CGCSAMR/Fotometro-Uchile/3D Printer/Piezas del Fotometro/Ensamblaje1.SLDASM

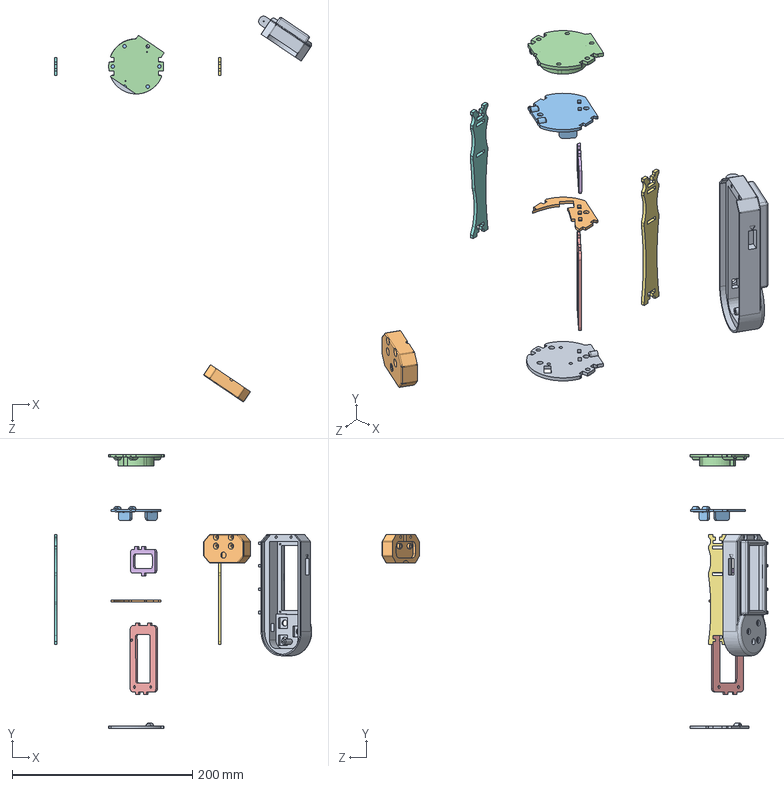
[picture p1: CAD file, 2014-07-22]
3D Printer/Piezas del Fotometro/Ensamblaje1.SLDASM
285.6 x 303.9 x 427.8 mm
segundo piso MAKERBOT
tercer piso MAKERBOT
cuarto piso PRINT edition MAKERBOT
quinto piso PRINT
central segundo pisoMAKERBOT
central tercer pisoMAKERBOT
soporte lateral MAKERBOT
soporte lateral MAKERBOT 2
soporte prueba
adaptador tipo A prueba
