CGCSAMR/Fotometro-Uchile/3D Printer/Piezas del Fotometro/Ensamblaje12.SLDASM

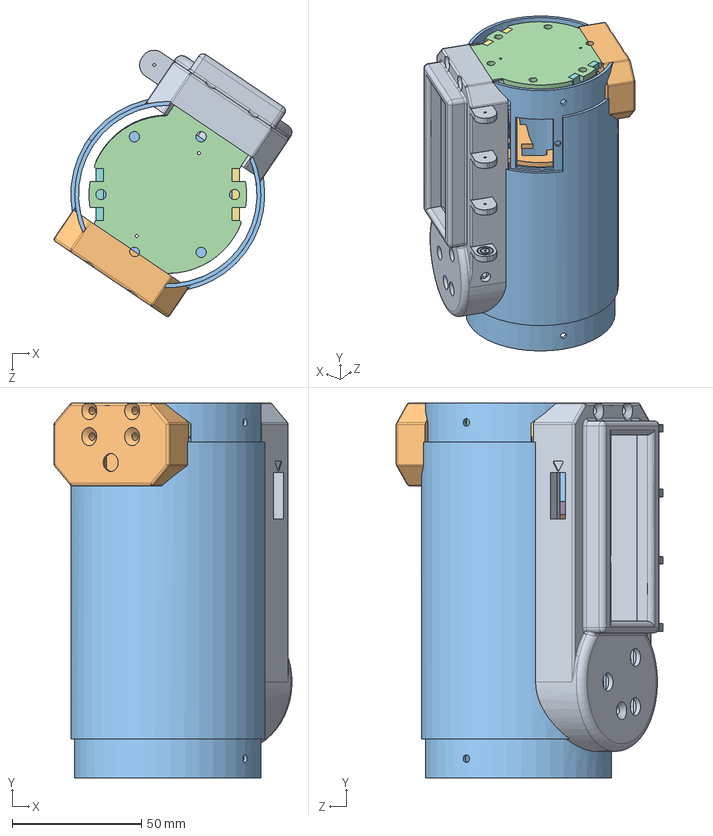
[picture p2: CAD file, 2014-07-22]
3D Printer/Piezas del Fotometro/Ensamblaje12.SLDASM
91.9 x 145.0 x 103.1 mm
segundo piso MAKERBOT
tercer piso MAKERBOT
cuarto piso PRINT edition MAKERBOT
quinto piso PRINT
central segundo pisoMAKERBOT
central tercer pisoMAKERBOT
soporte lateral MAKERBOT
soporte lateral MAKERBOT 2
soporte prueba
adaptador tipo A prueba
digitubo
