CGCSAMR/Fotometro-Uchile/CAD 3D/piezas del fotometro/fotometro.SLDASM

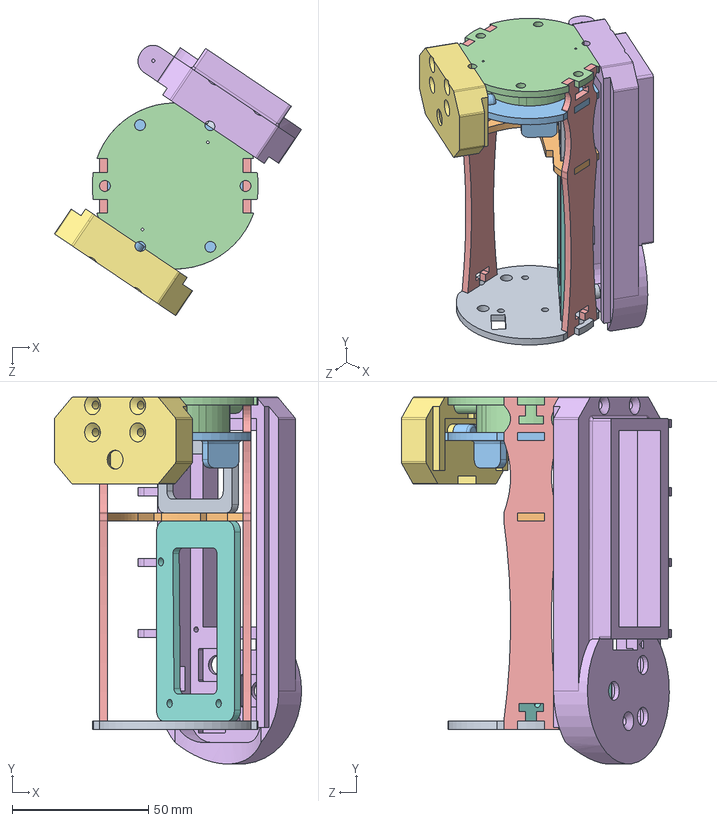
[picture p3: CAD file, 2014-02-21]
CAD 3D/piezas del fotometro/fotometro.SLDASM
90.7 x 134.7 x 99.3 mm
segundo piso
tercer piso
cuarto piso PRINT edition
quinto piso PRINT
soporte lateral x 2
soporte
adaptador tipo A
central segundo piso
central tercer piso
