CGCSAMR/Fotometro-Uchile/3D Printer/Piezas del Fotometro/Purgatorio/adaptador tipo A prueba 2013.STL

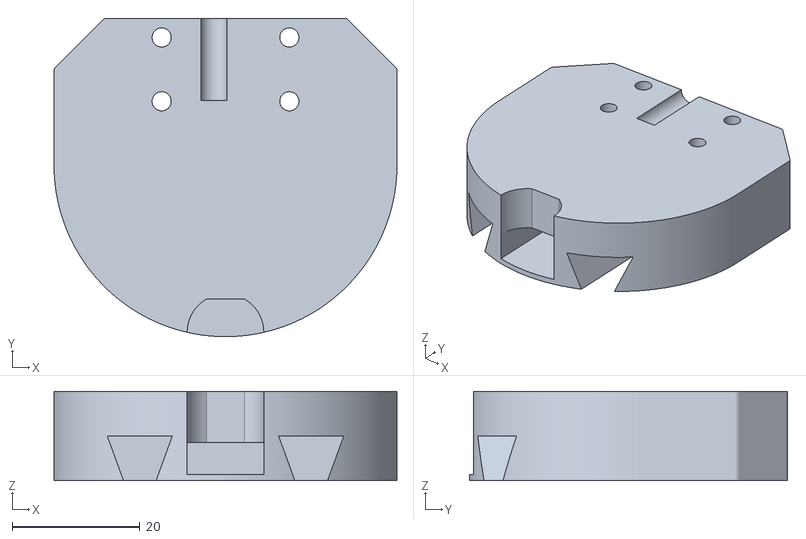
[picture p4: CAD file, 2014-07-22]
3D Printer/Piezas del Fotometro/Purgatorio/adaptador tipo A prueba 2013.STL
53.7 x 49.9 x 14.0
