CGCSAMR/Fotometro-Uchile/3D Printer/Piezas del Fotometro/soporte prueba mejorado.SLDPRT

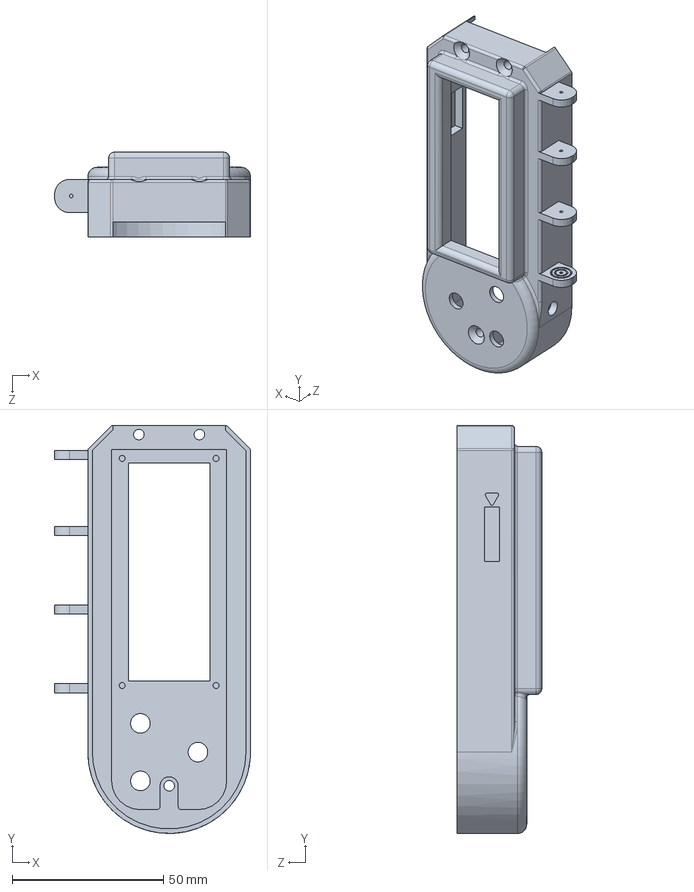
[picture p5: CAD file, 2014-08-05]
3D Printer/Piezas del Fotometro/soporte prueba mejorado.SLDPRT
64.7 x 134.7 x 28.0 mm
