CGCSAMR/Fotometro-Uchile/3D Printer/Piezas del Fotometro/STL/adaptador 2G.STL

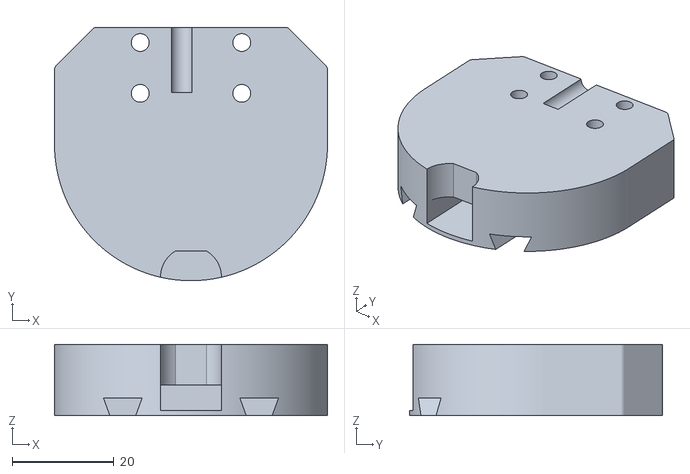
[picture p6: CAD file, 2014-07-25]
3D Printer/Piezas del Fotometro/STL/adaptador 2G.STL
53.7 x 49.9 x 14.0
