CGCSAMR/Fotometro-Uchile/CAD 3D/piezas del fotometro/central segundo pisoMAKERBOT.SLDPRT

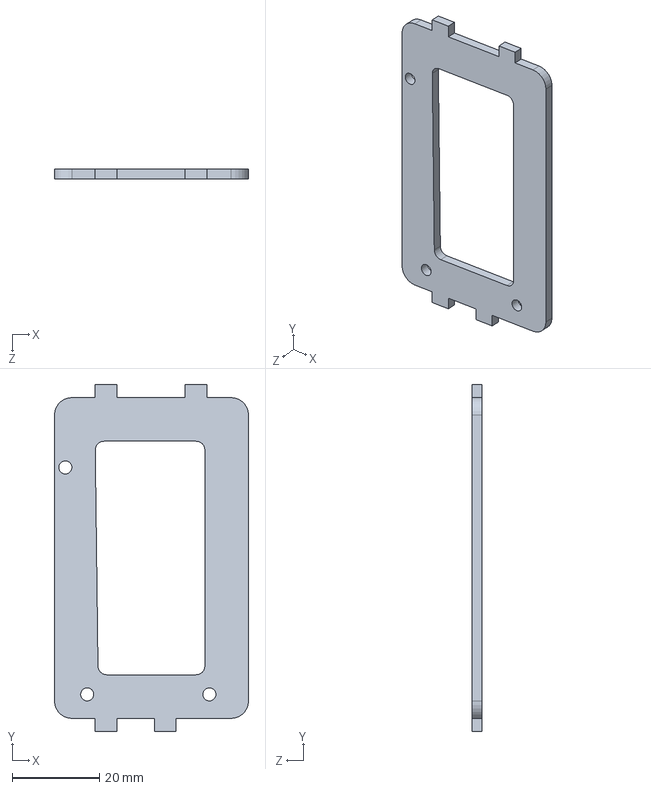
[picture p7: CAD file, 2014-02-21]
CAD 3D/piezas del fotometro/central segundo pisoMAKERBOT.SLDPRT
44.5 x 79.5 x 2.40 mm
