CGCSAMR/Fotometro-Uchile/3D Printer/Piezas del Fotometro/adaptador tipo A 2G.SLDPRT

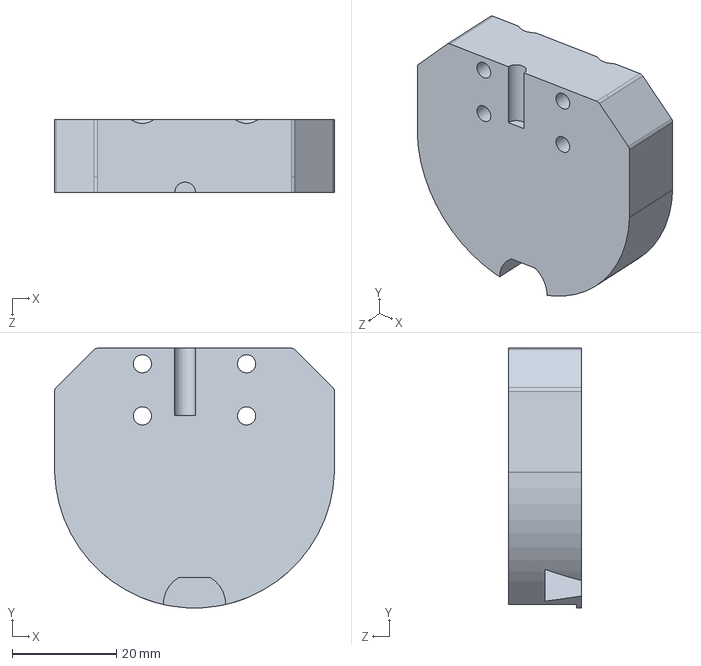
[picture p8: CAD file, 2014-08-02]
3D Printer/Piezas del Fotometro/adaptador tipo A 2G.SLDPRT
53.7 x 49.8 x 14.0 mm
