CGCSAMR/Fotometro-Uchile/3D Printer/Piezas del Fotometro/Purgatorio/adaptador tipo A prueba.STL

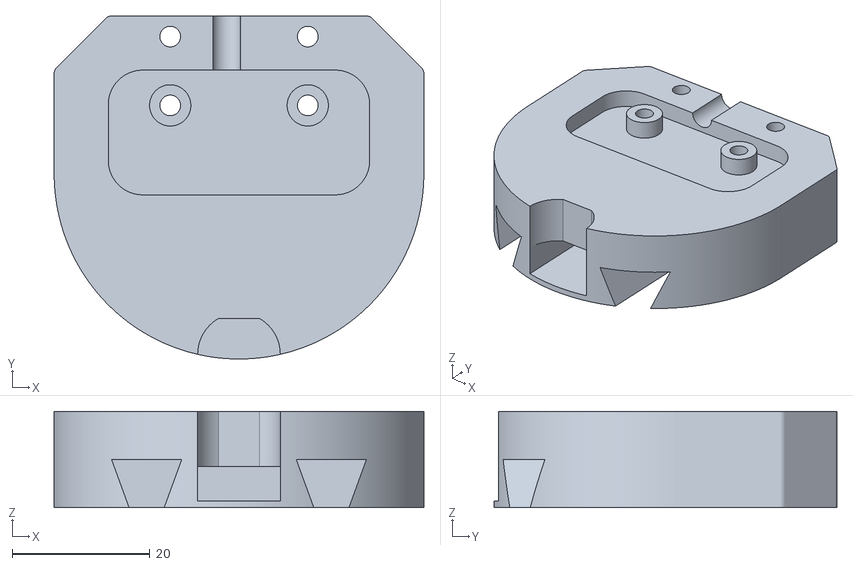
[picture p9: CAD file, 2014-07-22]
3D Printer/Piezas del Fotometro/Purgatorio/adaptador tipo A prueba.STL
53.7 x 49.9 x 14.0
