CGCSAMR/Fotometro-Uchile/3D Printer/Piezas del Fotometro/STL/quinto 1 piso PRINT.STL

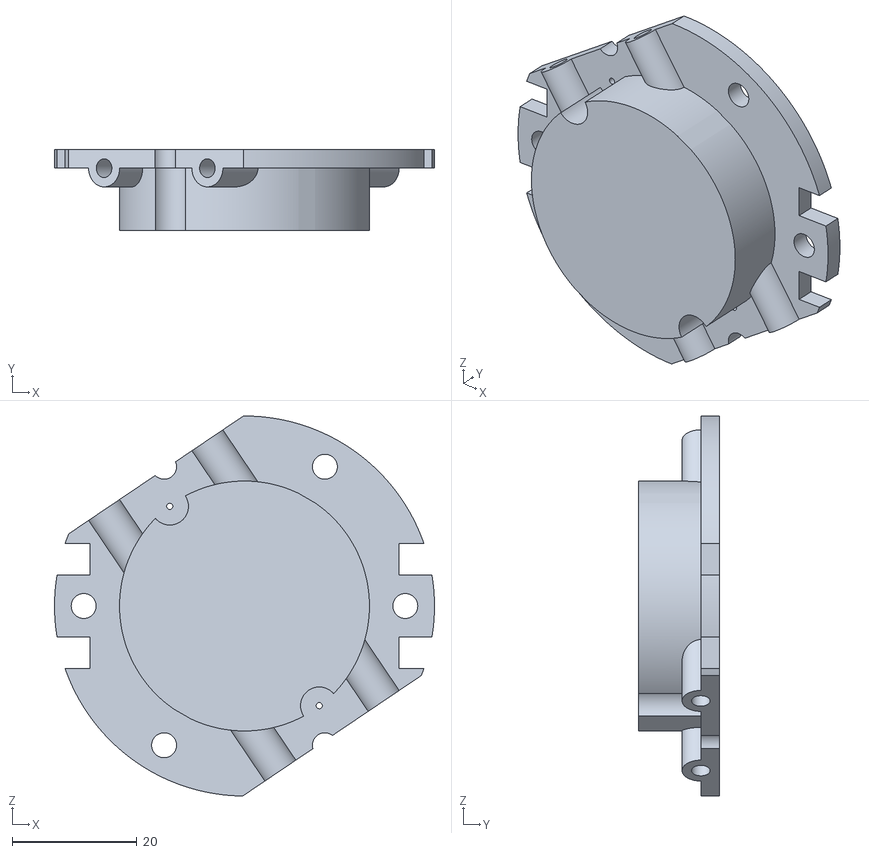
[picture p10: CAD file, 2014-02-21]
3D Printer/Piezas del Fotometro/STL/quinto 1 piso PRINT.STL
61.0 x 13.0 x 61.0
