CGCSAMR/Fotometro-Uchile/CAD 3D/piezas del fotometro/adaptador tipo A prueba.SLDPRT

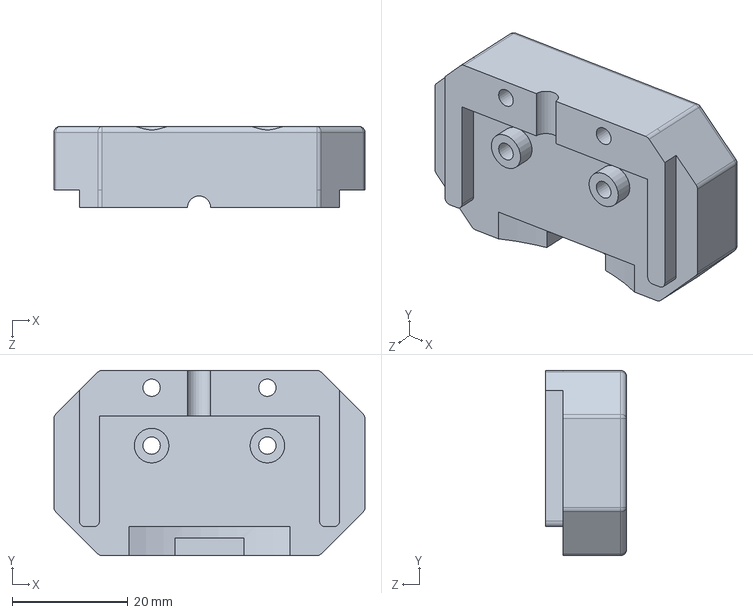
[picture p11: CAD file, 2014-02-21]
CAD 3D/piezas del fotometro/adaptador tipo A prueba.SLDPRT
53.7 x 32.0 x 14.0 mm
