CGCSAMR/Fotometro-Uchile/3D Printer/Piezas del Fotometro/Purgatorio/soporte lateral prueba.STL

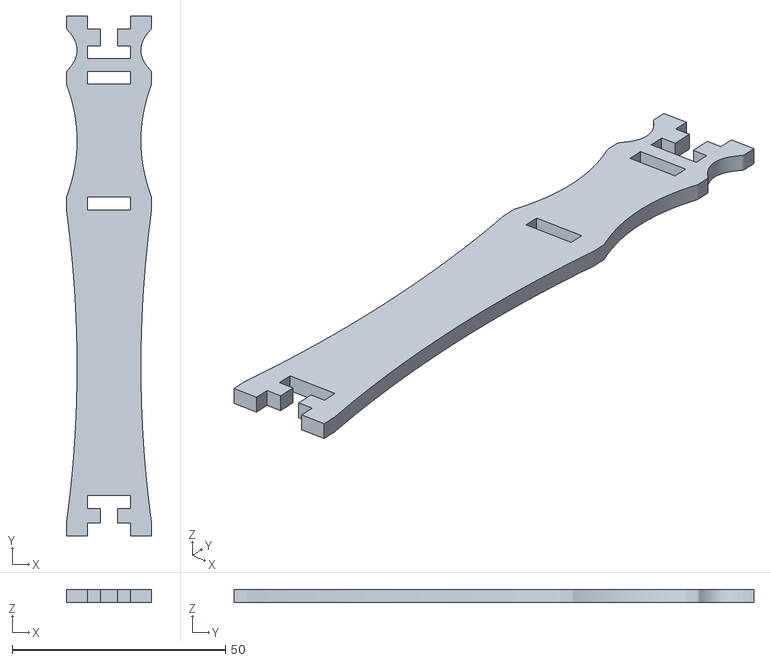
[picture p12: CAD file, 2014-02-21]
3D Printer/Piezas del Fotometro/Purgatorio/soporte lateral prueba.STL
20.0 x 122.0 x 3.00
