CGCSAMR/Fotometro-Uchile/3D Printer/Piezas del Fotometro/STL/tercer piso.STL

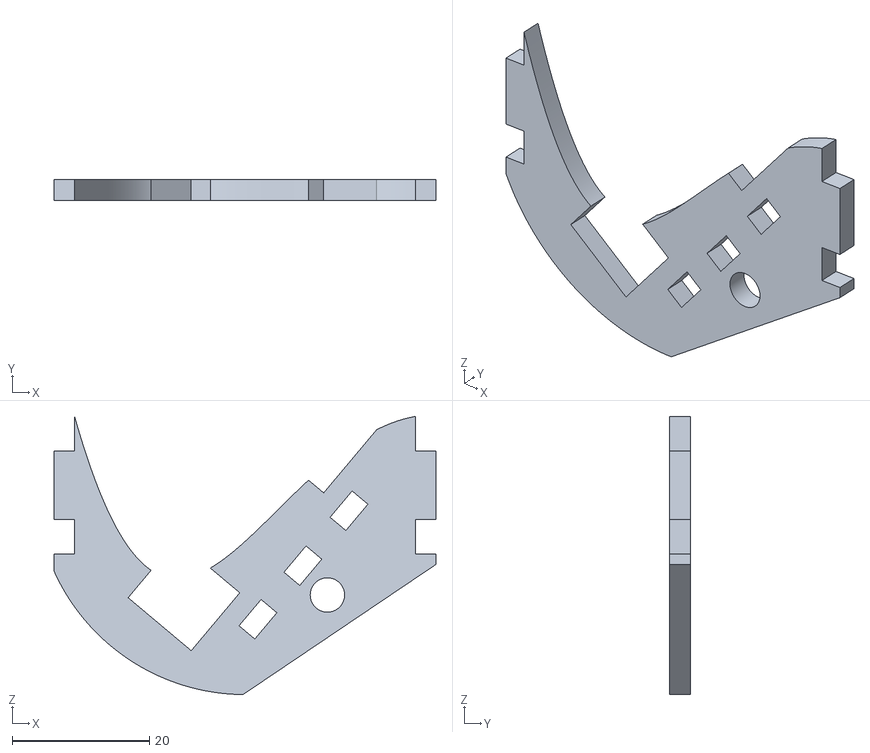
[picture p13: CAD file, 2014-01-23]
3D Printer/Piezas del Fotometro/STL/tercer piso.STL
55.6 x 3.00 x 40.5
