CGCSAMR/Fotometro-Uchile/CAD 3D/piezas del fotometro/central segundo piso.SLDPRT

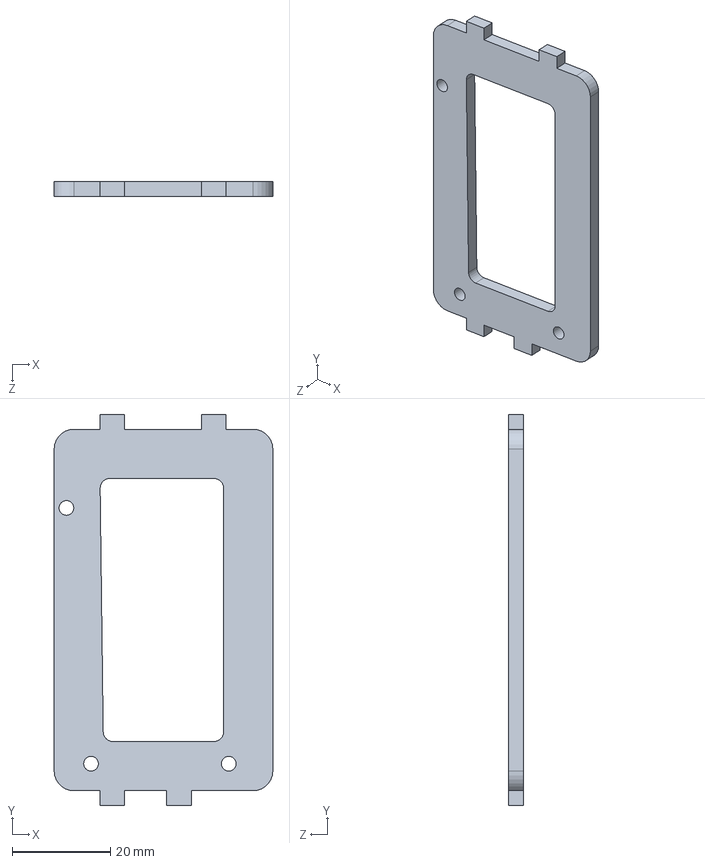
[picture p14: CAD file, 2014-02-21]
CAD 3D/piezas del fotometro/central segundo piso.SLDPRT
44.5 x 79.5 x 3.00 mm
