CGCSAMR/Fotometro-Uchile/3D Printer/Piezas del Fotometro/STL/central tercer piso.STL

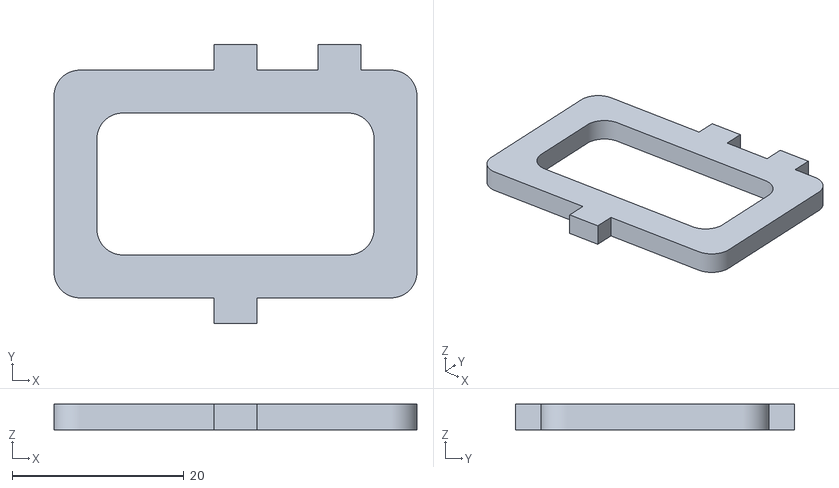
[picture p15: CAD file, 2014-01-09]
3D Printer/Piezas del Fotometro/STL/central tercer piso.STL
42.2 x 32.5 x 3.00
