CGCSAMR/Fotometro-Uchile/CAD 3D/piezas del fotometro/segundo piso MAKERBOT.SLDPRT

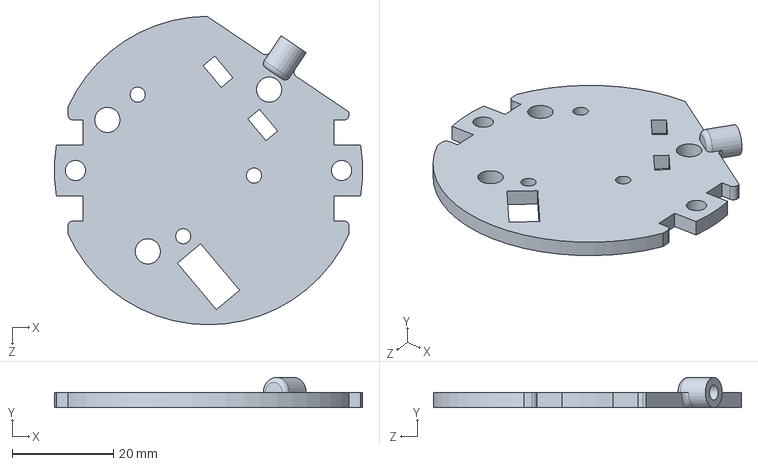
[picture p16: CAD file, 2014-02-21]
CAD 3D/piezas del fotometro/segundo piso MAKERBOT.SLDPRT
60.9 x 6.00 x 61.0 mm
