CGCSAMR/Fotometro-Uchile/3D Printer/Piezas del Fotometro/Purgatorio/adaptador tipo A.STL

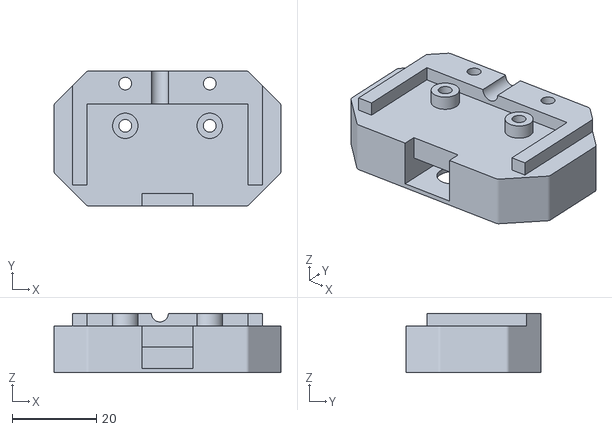
[picture p17: CAD file, 2014-02-21]
3D Printer/Piezas del Fotometro/Purgatorio/adaptador tipo A.STL
53.7 x 32.0 x 14.0
