CGCSAMR/Fotometro-Uchile/CAD 3D/piezas del fotometro/cuarto piso PRINT edition.SLDPRT

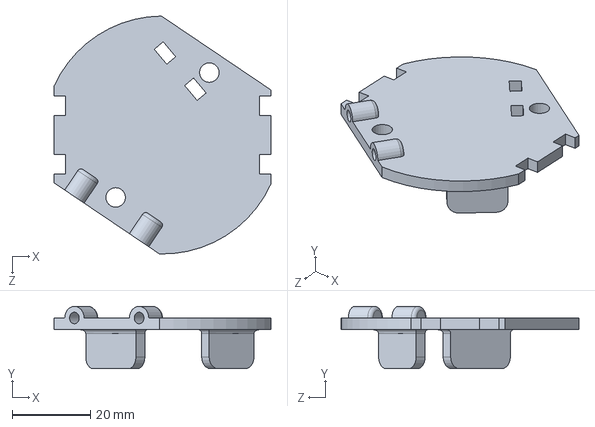
[picture p18: CAD file, 2014-02-21]
CAD 3D/piezas del fotometro/cuarto piso PRINT edition.SLDPRT
55.6 x 16.0 x 61.0 mm
