CGCSAMR/Fotometro-Uchile/3D Printer/Piezas del Fotometro/segundo piso MAKERBOT.SLDPRT

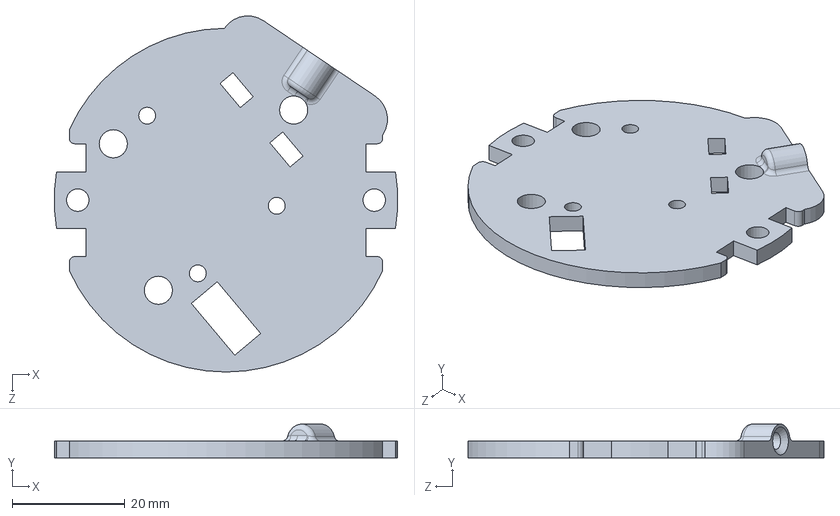
[picture p19: CAD file, 2014-07-25]
3D Printer/Piezas del Fotometro/segundo piso MAKERBOT.SLDPRT
60.9 x 5.98 x 63.2 mm
