CGCSAMR/Fotometro-Uchile/3D Printer/Piezas del Fotometro/soporte lateral MAKERBOT 2.SLDPRT

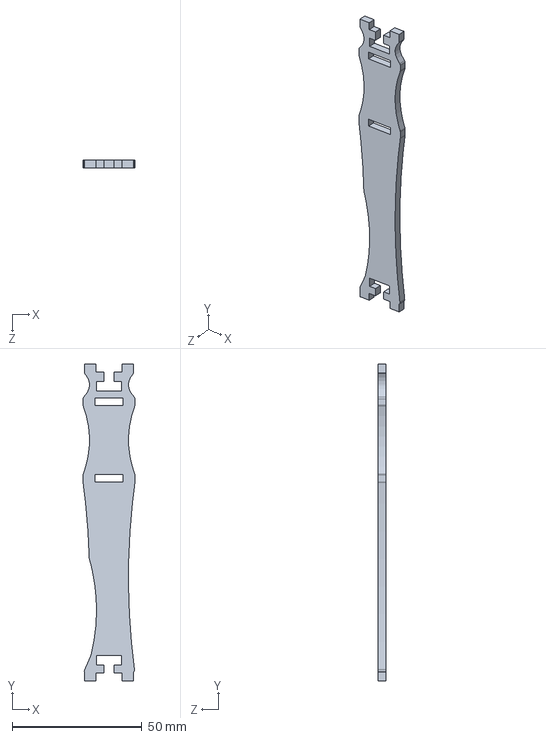
[picture p20: CAD file, 2014-07-25]
3D Printer/Piezas del Fotometro/soporte lateral MAKERBOT 2.SLDPRT
20.0 x 122.0 x 3.00 mm
