CGCSAMR/Fotometro-Uchile/CAD 3D/piezas del fotometro/soporte prueba.SLDPRT

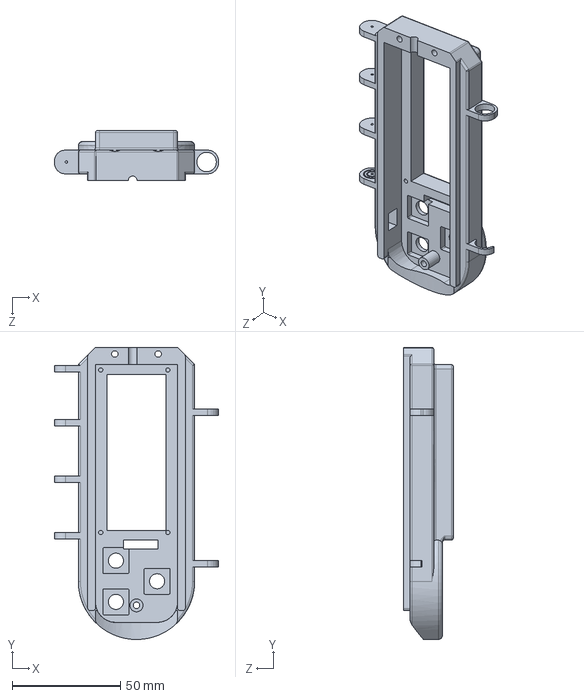
[picture p21: CAD file, 2014-02-21]
CAD 3D/piezas del fotometro/soporte prueba.SLDPRT
75.7 x 134.7 x 23.0 mm
