CGCSAMR/Fotometro-Uchile/CAD 3D/piezas del fotometro/soporte lateral prueba.SLDPRT

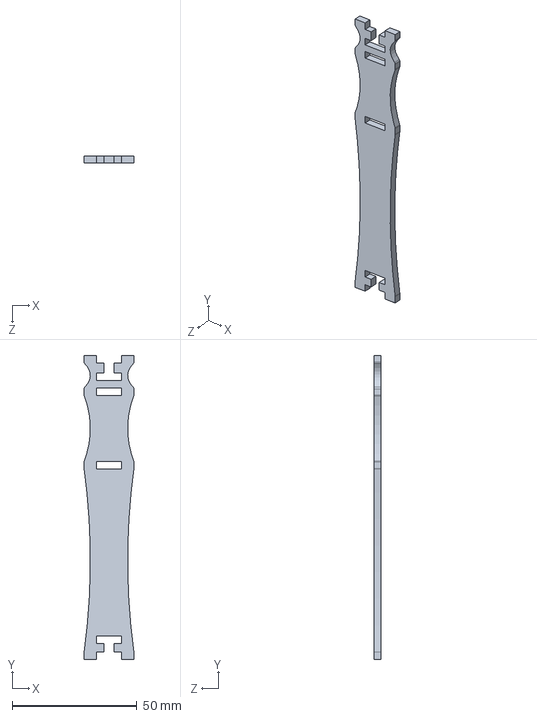
[picture p22: CAD file, 2014-02-21]
CAD 3D/piezas del fotometro/soporte lateral prueba.SLDPRT
20.0 x 122.0 x 3.00 mm
