CGCSAMR/Fotometro-Uchile/3D Printer/Piezas del Fotometro/quinto piso PRINT.SLDPRT

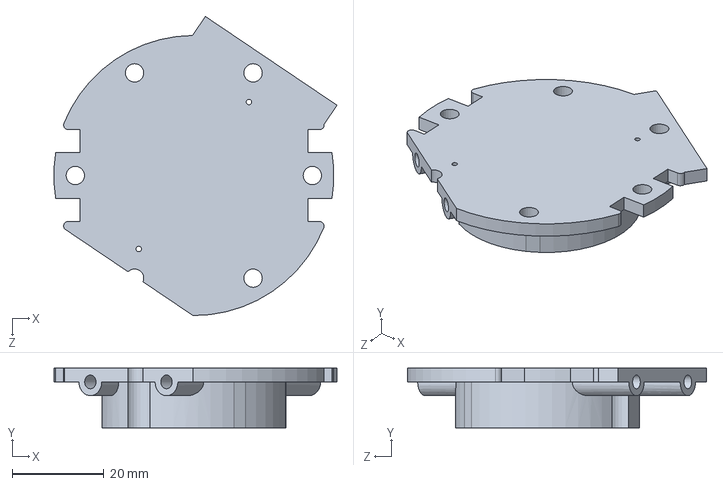
[picture p23: CAD file, 2014-07-22]
3D Printer/Piezas del Fotometro/quinto piso PRINT.SLDPRT
61.6 x 13.0 x 65.1 mm
