CGCSAMR/Fotometro-Uchile/CAD 3D/piezas del fotometro/soporte.SLDPRT

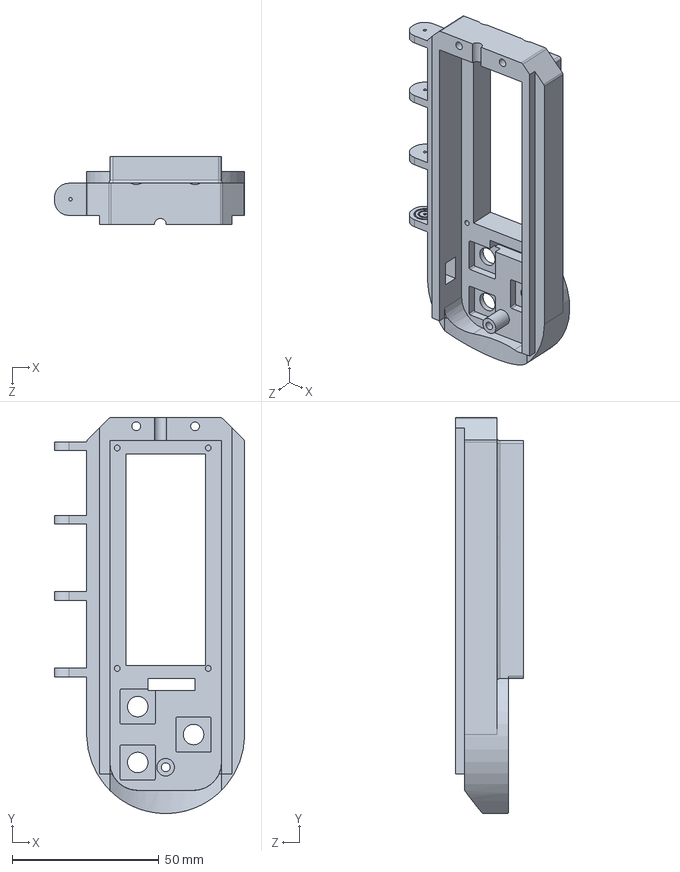
[picture p24: CAD file, 2014-02-21]
CAD 3D/piezas del fotometro/soporte.SLDPRT
64.7 x 134.7 x 23.0 mm
