CGCSAMR/Fotometro-Uchile/3D Printer/Piezas del Fotometro/digitubo.SLDPRT

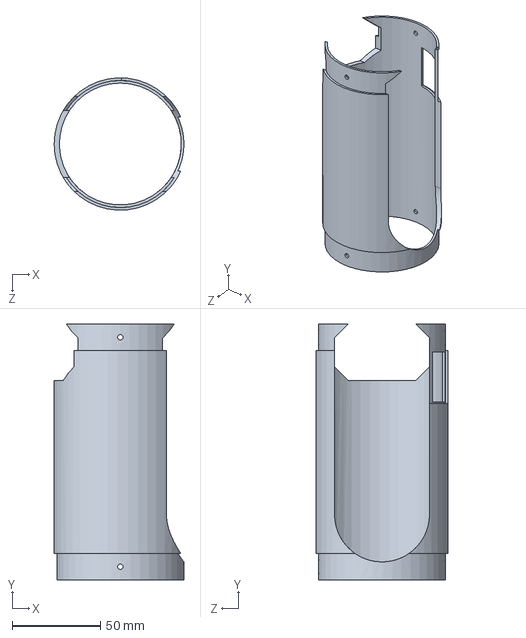
[picture p25: CAD file, 2014-07-22]
3D Printer/Piezas del Fotometro/digitubo.SLDPRT
73.5 x 145.0 x 75.0 mm
