CGCSAMR/Fotometro-Uchile/CAD 3D/piezas del fotometro/cuarto piso PRINT edition MAKERBOT.SLDPRT

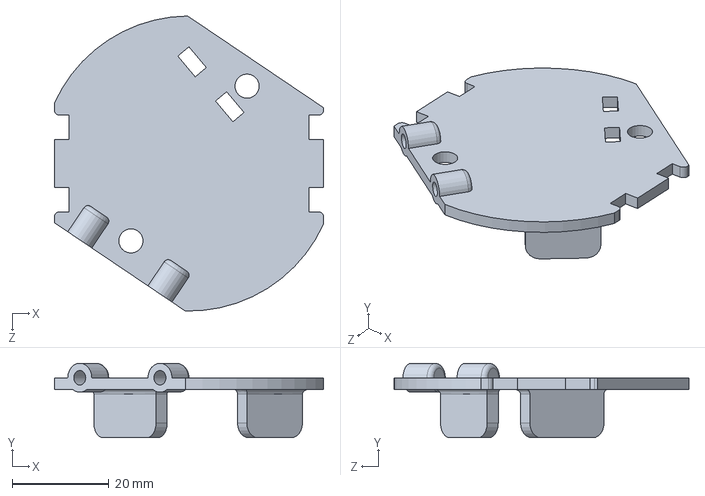
[picture p26: CAD file, 2014-02-21]
CAD 3D/piezas del fotometro/cuarto piso PRINT edition MAKERBOT.SLDPRT
55.6 x 15.4 x 61.0 mm
