CGCSAMR/Fotometro-Uchile/CAD 3D/piezas del fotometro/central tercer pisoMAKERBOT.SLDPRT

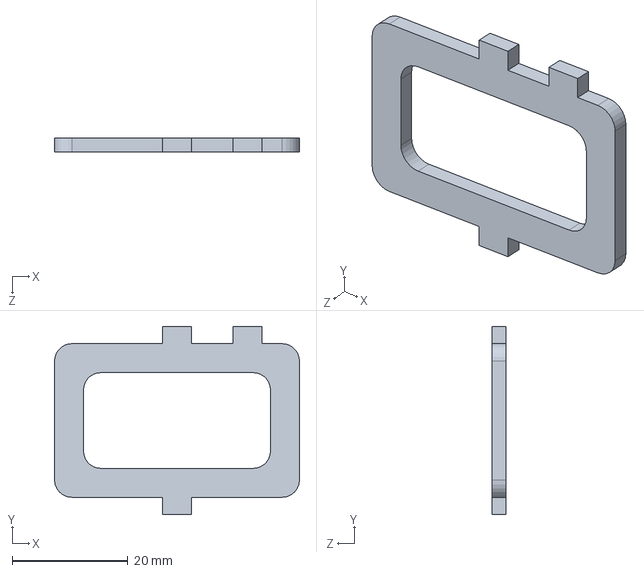
[picture p27: CAD file, 2014-02-21]
CAD 3D/piezas del fotometro/central tercer pisoMAKERBOT.SLDPRT
42.2 x 32.5 x 2.40 mm
