CGCSAMR/Fotometro-Uchile/CAD 3D/piezas del fotometro/tercer piso MAKERBOT.SLDPRT

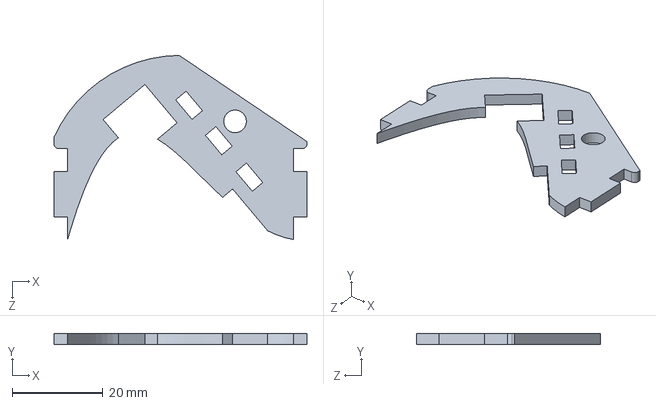
[picture p28: CAD file, 2014-02-21]
CAD 3D/piezas del fotometro/tercer piso MAKERBOT.SLDPRT
55.6 x 2.40 x 40.5 mm
