CGCSAMR/Fotometro-Uchile/(list of files, cad)

Other CAD files:
CAD 3D/pieza molde/molde de corte 1.SLDPRT
CAD 3D/pieza molde/quinto piso PRINT corte.SLDPRT
3D Printer/Piezas del Fotometro/adaptador tipo A prueba 2013.SLDPRT
CAD 3D/pieza molde/molde corte 2.SLDPRT
3D Printer/Piezas del Fotometro/Molde rehecho.SLDPRT
3D Printer/Piezas del Fotometro/Purgatorio/central segundo piso.STL
3D Printer/Piezas del Fotometro/soporte lateral MAKERBOT.SLDPRT
3D Printer/Piezas del Fotometro/Purgatorio/quinto piso PRINT.STL
CAD 3D/piezas del fotometro/soporte lateral MAKERBOT.SLDPRT
3D Printer/Piezas del Fotometro/Purgatorio/soporte lateral.STL
3D Printer/Piezas del Fotometro/quinto piso PRINT corte.SLDPRT
CAD 3D/piezas del fotometro/adaptador tipo A.SLDPRT
CAD 3D/piezas del fotometro/quinto piso PRINT.SLDPRT
3D Printer/Piezas del Fotometro/central segundo pisoMAKERBOT ad.SLDPRT
CAD 3D/piezas del fotometro/quinto piso molde.SLDPRT
3D Printer/Piezas del Fotometro/molde de corte 1.SLDPRT
CAD 3D/piezas del fotometro/segundo piso.SLDPRT
3D Printer/Piezas del Fotometro/molde corte 2.SLDPRT
CAD 3D/piezas del fotometro/adaptador tipo B.SLDPRT
CAD 3D/piezas del fotometro/soporte lateral.SLDPRT
CAD 3D/piezas del fotometro/central tercer piso.SLDPRT
CAD 3D/piezas del fotometro/tercer piso.SLDPRT
3D Printer/Piezas del Fotometro/Old/adaptador tipo A prueba.SLDPRT
3D Printer/Piezas del Fotometro/Old/soporte prueba.SLDPRT
3D Printer/Piezas del Fotometro/STL/central segundo pisoMAKERBOT ad.STL
3D Printer/Piezas del Fotometro/STL/soporte lateral MAKERBOT 2.STL
3D Printer/Piezas del Fotometro/STL/soporte lateral MAKERBOT.STL
3D Printer/Piezas del Fotometro/adaptador tipo A 2G.STL
3D Printer/Piezas del Fotometro/corte 1.SLDDRW
3D Printer/Piezas del Fotometro/molde de corte 1.SLDDRW
3D Printer/Piezas del Fotometro/segundo piso MAKERBOT.SLDDRW
CAD 3D/pieza molde/molde corte 2.SLDDRW
CAD 3D/pieza molde/quinto piso PRINT corte.SLDDRW
CAD 3D/piezas del fotometro/moldes laterales.SLDDRW
CAD 3D/piezas del fotometro/quinto piso molde.SLDDRW
