CGCSAMR/Fotometro-Uchile/Kicad/resistencias-precalibracion.txt

Led A3
Resistencias: 1.5 MOhm
Condensador: -

Led B3
Resistencias: 10 MOhm
Condensador: -
