CGCSAMR/Fotometro-Uchile/Data/la_Parva/tabla_calibracion_laParva.ods

Fotómetro | V0 556nm | Coef. Rayleigh 556nm | Coef. Corr 556nm
Falvey | 679,9633 | 0,1338 | 0,9783
Roberto | 709,2878 | 0,1037 | 0,7677
Marcos | 768,3368 | 0,1515 | 0,9434
Promedio | 719,20 | 0,13 | 0,90
Std | 45,01 | 0,02 | 0,11
Std% | 6,26 | 18,64 | 12,59
Fotómetro | V0 414nm | Coef. Rayleigh 414nm | Coef. Corr 414nm
Falvey | 733,5996 | 0,2732 | 0,7978
Roberto | 737,1295 | 0,2538 | 0,8565
Marcos | 769,4022 | 0,2486 | 0,9346
Promedio | 746,71 | 0,26 | 0,86
Std | 19,73 | 0,01 | 0,07
Std% | 2,64 | 5,01 | 7,95
