CGCSAMR/Fotometro-Uchile/Data/previo_calibracion_feb2015/data_falvey.csv

Year | Month | Day | Hour | Minute | Second | Sens_556_nm | Sens_414_nm | Temperature_C | Pressure_Pa | Altitude_m
2015 | 1 | 21 | 20 | 14 | 35 | 634 | 648 | 25.137501 | 95242 | 533.26105
2015 | 1 | 21 | 20 | 15 | 3 | 633 | 648 | 25.293751 | 95249 | 533.26105
2015 | 1 | 21 | 20 | 15 | 36 | 624 | 643 | 25.512501 | 95246 | 532.82507
2015 | 1 | 21 | 20 | 16 | 3 | 642 | 648 | 25.725 | 95252 | 532.6507
2015 | 1 | 21 | 20 | 16 | 58 | 618 | 640 | 26.09375 | 95242 | 533.17389
2015 | 1 | 21 | 20 | 17 | 25 | 617 | 636 | 26.275 | 95237 | 533.34827
2015 | 1 | 21 | 20 | 17 | 49 | 620 | 642 | 26.43125 | 95246 | 533.34827
2015 | 1 | 21 | 20 | 18 | 13 | 621 | 644 | 26.625 | 95240 | 534.31268
2015 | 1 | 21 | 20 | 19 | 23 | 614 | 631 | 27.1 | 95244 | 533.78687
2015 | 1 | 21 | 20 | 19 | 48 | 606 | 631 | 27.275 | 95242 | 533.61249
2015 | 1 | 21 | 20 | 20 | 19 | 612 | 619 | 27.475 | 95227 | 533.9613
2015 | 1 | 21 | 20 | 54 | 50 | 492 | 444 | 27.86875 | 95223 | 535.1001
2015 | 1 | 21 | 20 | 55 | 18 | 492 | 435 | 27.93125 | 95215 | 535.62592
2015 | 1 | 21 | 20 | 55 | 45 | 492 | 443 | 27.99375 | 95216 | 535.71313
2015 | 1 | 22 | 15 | 0 | 29 | 508 | 494 | 26.93125 | 95204 | 537.81372
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
