CGCSAMR/Fotometro-Uchile/Data/previo_calibracion_feb2015/data_marcos.csv

Year | Month | Day | Hour | Minute | Second | Sens_556_nm | Sens_414_nm | Temperature_C | Pressure_Pa | Altitude_m
2015 | 1 | 21 | 20 | 13 | 5 | 700 | 625 | 24.31875 | 95183 | 538.60114
2015 | 1 | 21 | 20 | 13 | 46 | 707 | 634 | 24.549999 | 95178 | 538.95251
2015 | 1 | 21 | 20 | 14 | 23 | 704 | 631 | 24.88125 | 95174 | 538.68829
2015 | 1 | 21 | 20 | 15 | 29 | 709 | 629 | 25.262501 | 95170 | 538.95251
2015 | 1 | 21 | 20 | 15 | 57 | 704 | 620 | 25.487499 | 95172 | 539.47571
2015 | 1 | 21 | 20 | 16 | 22 | 646 | 622 | 25.725 | 95186 | 539.21411
2015 | 1 | 21 | 20 | 16 | 47 | 707 | 627 | 26 | 95174 | 539.91431
2015 | 1 | 21 | 20 | 21 | 30 | 605 | 602 | 27.50625 | 95161 | 540.6145
2015 | 1 | 21 | 20 | 21 | 58 | 492 | 597 | 27.606251 | 95158 | 540.00153
2015 | 1 | 21 | 20 | 22 | 33 | 682 | 601 | 27.799999 | 95164 | 540.70172
2015 | 1 | 21 | 20 | 23 | 11 | 690 | 602 | 28.00625 | 95166 | 540.52734
2015 | 1 | 21 | 20 | 24 | 18 | 695 | 600 | 28.34375 | 95159 | 540.08868
2015 | 1 | 22 | 13 | 45 | 55 | 562 | 521 | 22.85 | 95302 | 528.88812
2015 | 1 | 22 | 15 | 9 | 58 | 541 | 495 | 27.0375 | 95128 | 543.50519
2015 | 1 | 22 | 15 | 10 | 34 | 523 | 516 | 27.174999 | 95129 | 543.33081
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
