CGCSAMR/Fotometro-Uchile/Data/previo_calibracion_feb2015/data_roberto.csv

Year | Month | Day | Hour | Minute | Second | Sens_556_nm | Sens_414_nm | Temperature_C | Pressure_Pa | Altitude_m
2015 | 1 | 21 | 20 | 12 | 47 | 555 | 609 | 24.012501 | 95391 | 521.01941
2015 | 1 | 21 | 20 | 13 | 31 | 640 | 608 | 24.2875 | 95387 | 520.75519
2015 | 1 | 21 | 20 | 14 | 1 | 177 | 611 | 24.525 | 95386 | 520.84241
2015 | 1 | 21 | 20 | 14 | 29 | 645 | 593 | 24.775 | 95384 | 521.28101
2015 | 1 | 21 | 20 | 16 | 42 | 634 | 599 | 25.768749 | 95380 | 521.5426
2015 | 1 | 21 | 20 | 17 | 6 | 638 | 592 | 25.9125 | 95386 | 520.49359
2015 | 1 | 21 | 20 | 17 | 34 | 638 | 602 | 26.106251 | 95376 | 521.45538
2015 | 1 | 21 | 20 | 18 | 26 | 628 | 605 | 26.43125 | 95386 | 521.01941
2015 | 1 | 21 | 20 | 19 | 20 | 625 | 570 | 26.775 | 95375 | 522.33002
2015 | 1 | 21 | 20 | 19 | 52 | 618 | 595 | 26.987499 | 95379 | 522.06573
2015 | 1 | 21 | 20 | 20 | 20 | 629 | 575 | 27.19375 | 95373 | 521.5426
2015 | 1 | 21 | 20 | 20 | 50 | 629 | 592 | 27.40625 | 95367 | 522.59155
2015 | 1 | 21 | 20 | 21 | 16 | 610 | 519 | 27.612499 | 95372 | 522.59155
2015 | 1 | 21 | 20 | 21 | 42 | 626 | 586 | 27.8125 | 95374 | 522.2428
2015 | 1 | 21 | 20 | 22 | 9 | 621 | 580 | 28.03125 | 95371 | 522.41718
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
