CGCSAMR/Fotometro-Uchile/Math/FotoScripts/graficos/comparacion_calibracion_feb.png

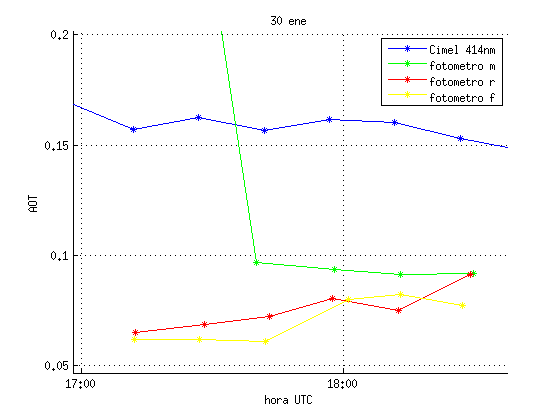
Math/FotoScripts/graficos/comparacion_calibracion_feb.png
