CGCSAMR/Fotometro-Uchile/Math/FotoScripts/langley_calibration/calibracion/calibracion_falvey.png

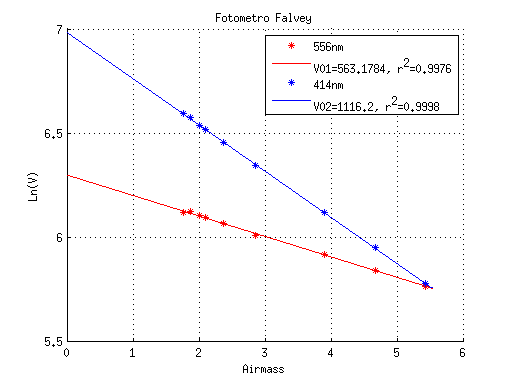
Math/FotoScripts/langley_calibration/calibracion/calibracion_falvey.png
