CGCSAMR/Fotometro-Uchile/Math/FotoScripts/langley_calibration/calibracion/calibracion_marcos.png

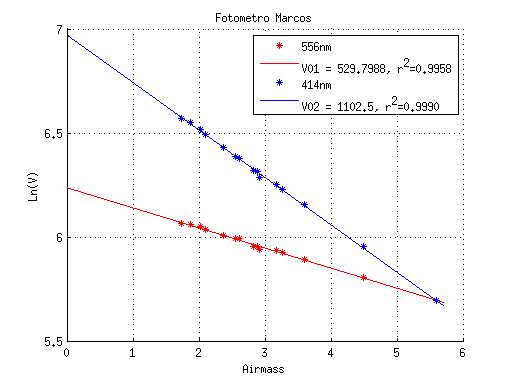
Math/FotoScripts/langley_calibration/calibracion/calibracion_marcos.png
