CGCSAMR/Fotometro-Uchile/Math/FotoScripts/langley_calibration/calibracion/calibracion_roberto.png

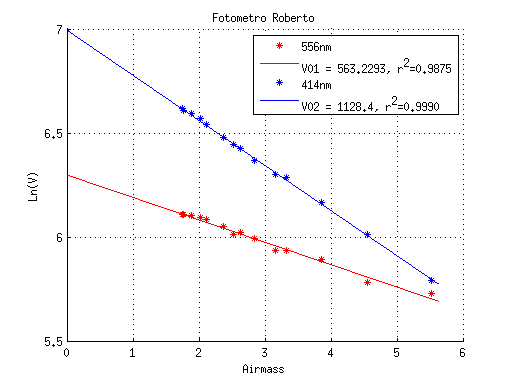
Math/FotoScripts/langley_calibration/calibracion/calibracion_roberto.png
