CGCSAMR/Fotometro-Uchile/Math/FotoScripts/langley_calibration/ejemplo_langley.png

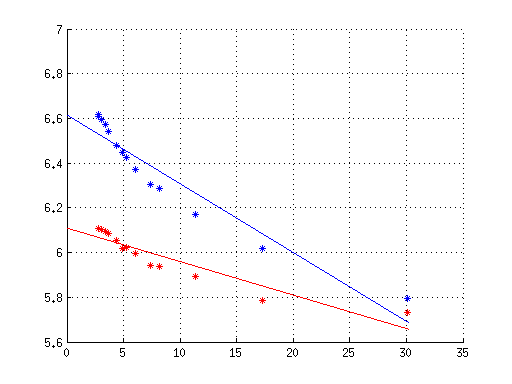
Math/FotoScripts/langley_calibration/ejemplo_langley.png
