CGCSAMR/Fotometro-Uchile/Kicad/placas/INTER1.kicad_pcb

## KiCad design Kicad/placas/INTER1.kicad_pcb (2014-08-23)

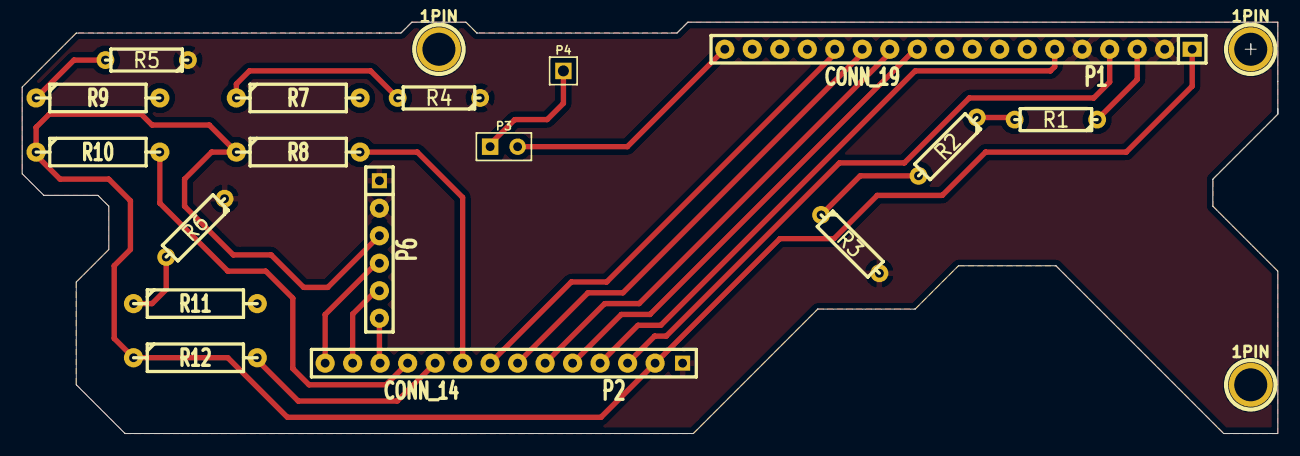
[picture p41: board INTER1.kicad_pcb from above]

Board: 2 copper layers, 116.0 x 38.0 mm, 20 parts (0 on the bottom side), 22 nets.

Parts:
1PIN, 1PIN#2, 1PIN#3: P***; 1pin
P1: CONN_19; SIL-18
P2: CONN_14; SIL-14
P3: CONN_2; PIN_ARRAY_2X1
P4: CONN_1; PIN_ARRAY_1
P6: CONN_6; SIL-6
R1, R2, R3, R4, R5, R6: R; R3-LARGE_PADS
R7, R8, R9, R10, R11, R12: R; R4-5

Connections:
+5V: P1.1, P2.2, P6.3, R8.1, R10.1, R12.1
/2: P1.14, P2.8
/3: P1.13, P2.7
/4: P1.12, P2.6
/6: P1.11, P2.5
/7: P2.9, R8.2
/9: P1.4, P2.3
/10: P1.6, P2.4
/A2: P2.10, R12.2
/A3: P2.11, R10.2
/BAT: P1.18, P3.2
/R: P1.3, R1.1
/RST: P2.12, P6.6
/RX1: P2.13, P6.5
/TX0: P2.14, P6.4
/Vin: P3.1, P4.1
GND: P1.2, P1.5, P2.1, P6.1, P6.2, R3.2, R4.1, R5.1, R6.1
unnamed: R6.2, R11.1
unnamed: R4.2, R7.1
unnamed: R2.2, R3.1
unnamed: R1.2, R2.1
unnamed: R5.2, R9.1
