CGCSAMR/Fotometro-Uchile/Kicad/placas/noname.kicad_pcb

## KiCad design Kicad/placas/noname.kicad_pcb (2014-08-23)

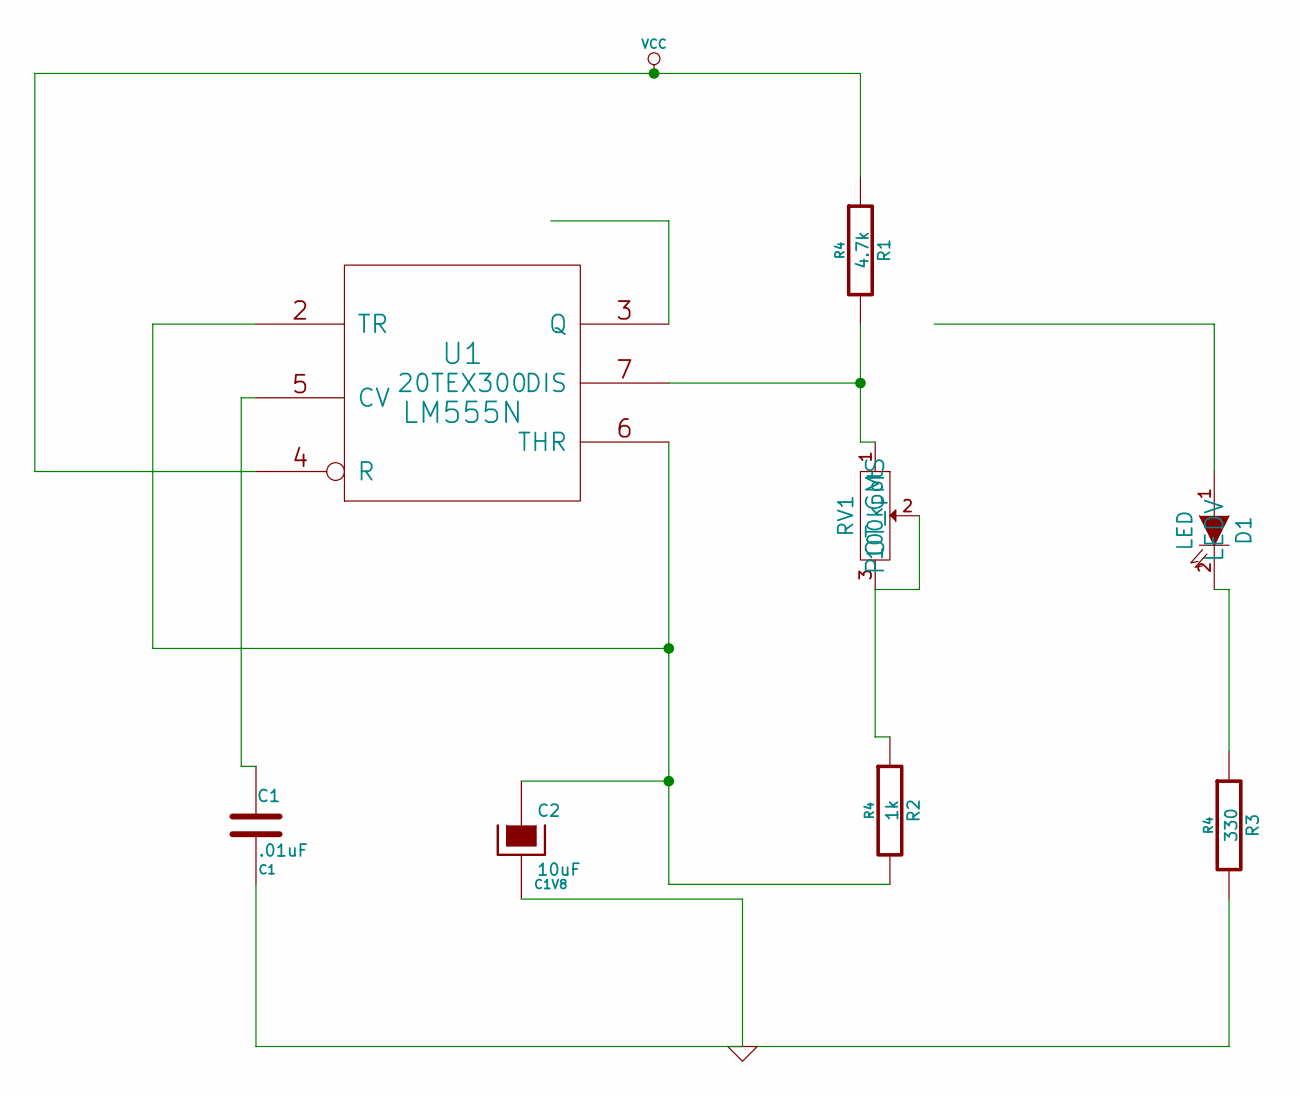
[picture p43: schematic noname.sch]

Parts:
C1: .01uF; C1
C2: 10uF; C1V8
D1: LED; LEDV
R1: 4.7k; R4
R2: 1k; R4
R3: 330; R4
RV1: 100kpot; POT_CMS
U1: LM555N; 20TEX300

Connections:
GND: C1.2, C2.2, U1.1 (GND)
unnamed: C1.1, U1.5 (CV)
unnamed: C2.1, R2.2, U1.2 (TR), U1.6 (THR)
unnamed: R2.1, RV1.2, RV1.3
unnamed: D1.2 (K), R3.1
unnamed: R1.2, RV1.1, U1.7 (DIS)
VCC: R1.1, U1.4 (R), U1.8 (VCC)

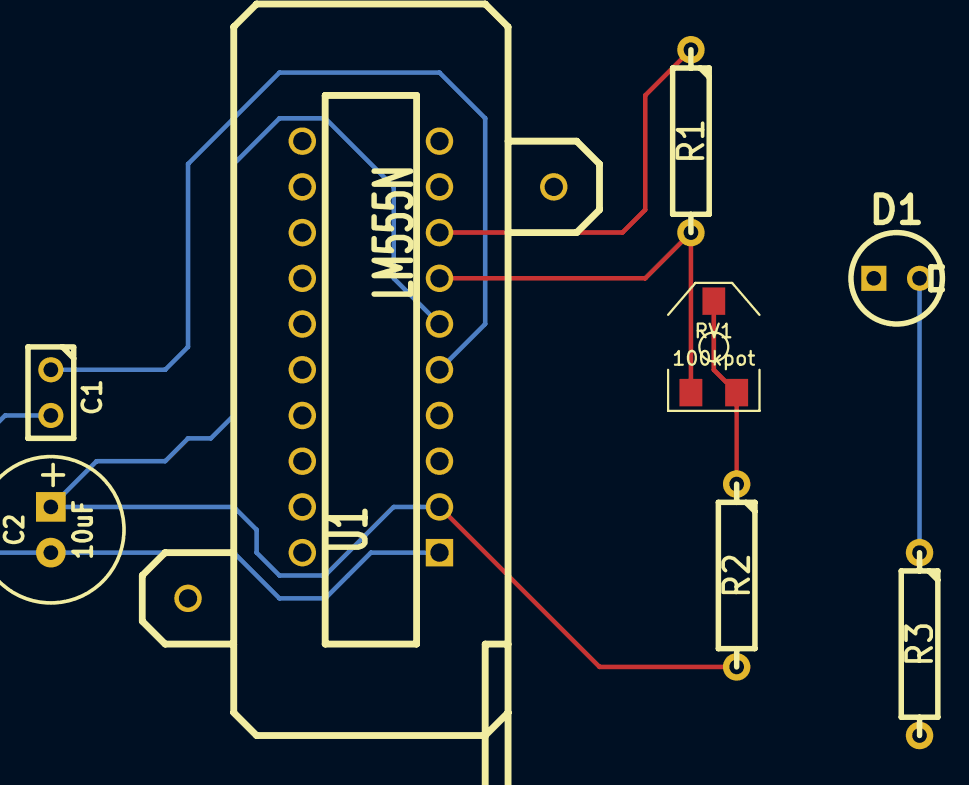
[picture p44: board noname.kicad_pcb from above]

Board: 2 copper layers, 8 parts (0 on the bottom side), 7 nets.
