CGCSAMR/Fotometro-Uchile/Kicad/placas/replaca.kicad_pcb

## KiCad design Kicad/placas/replaca.kicad_pcb (2014-08-23)

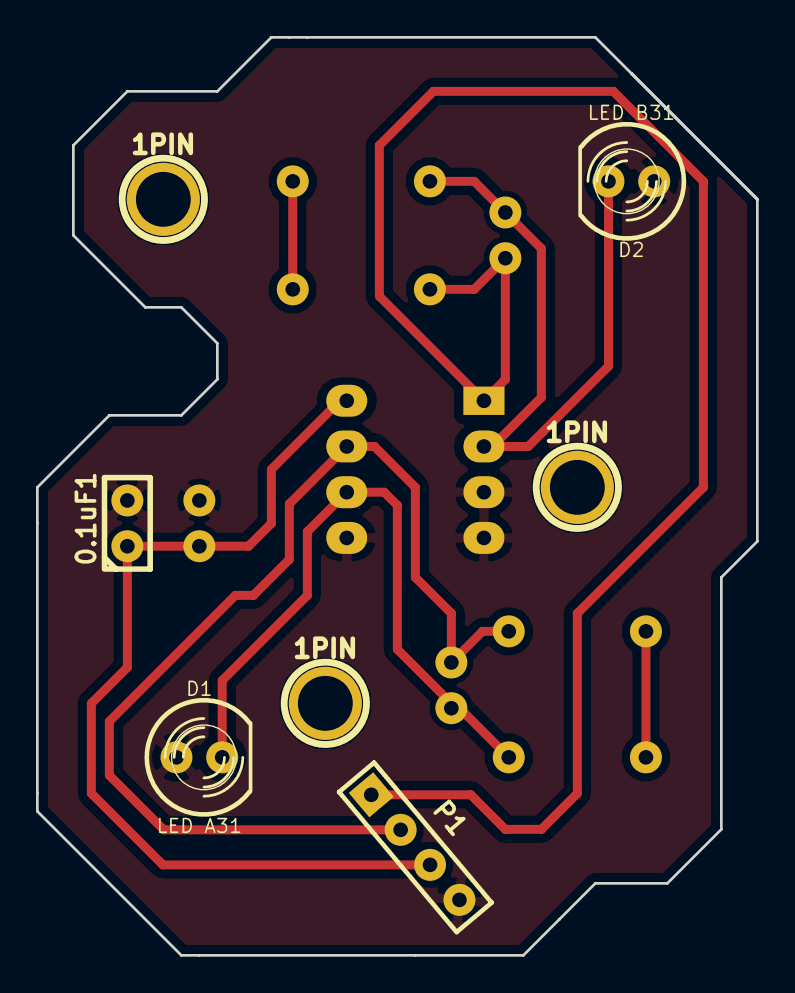
[picture p45: board replaca.kicad_pcb from above]

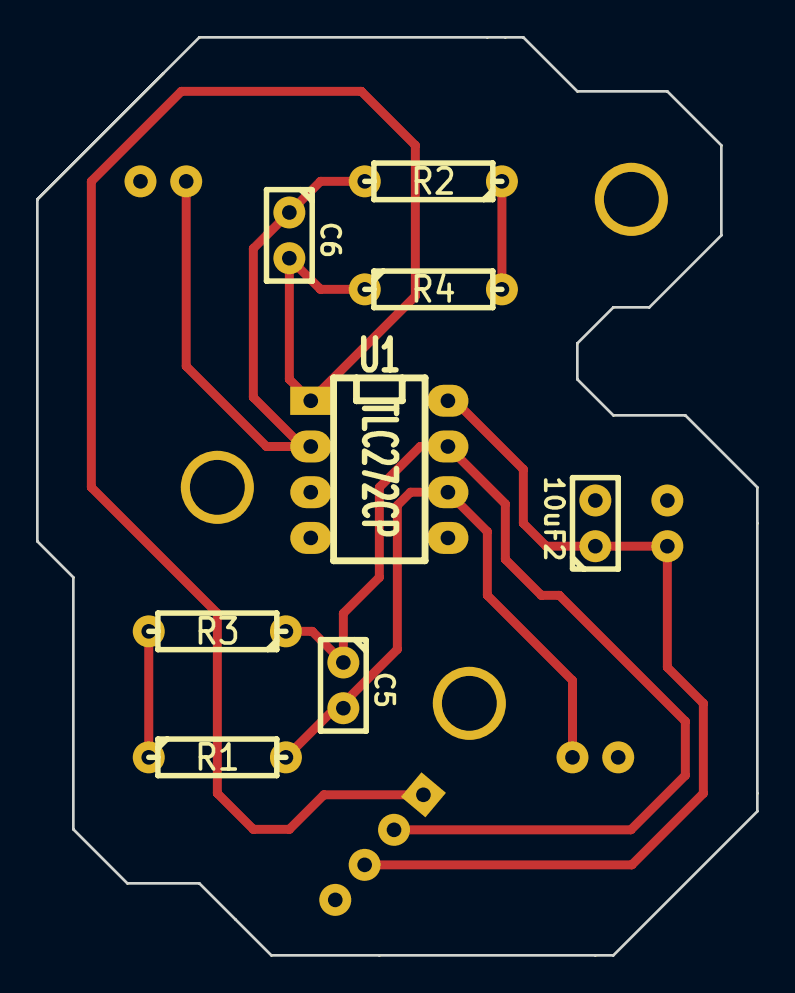
[picture p46: board replaca.kicad_pcb from below]

Board: 2 copper layers, 40.0 x 51.0 mm, 15 parts (8 on the bottom side), 8 nets.

Parts:
0.1uF1: C1
1PIN, 1PIN#2, 1PIN#3: P***; 1pin
10uF2: CP1; C1
C5, C6: 0.1uF; C1
D1: LED A31; LED-5MM
D2: LED B31; LED-5MM
P1: CONN_4; PIN_ARRAY_4x1
R1, R2, R3, R4: R; R3-LARGE_PADS
U1: TLC272CP; DIP-8__300_ELL

Connections:
+5V: 0.1uF1.1, 10uF2.1, P1.3, U1.8
/2: C6.1, D2.2, R2.2, U1.2
/6: C5.2, D1.2, R1.2, U1.6
/A1: C6.2, P1.1, R4.1, U1.1
/A2: C5.1, P1.2, R3.1, U1.7
GND: 0.1uF1.2, 10uF2.2, D1.1, D2.1, P1.4, U1.3, U1.4, U1.5
unnamed: R2.1, R4.2
unnamed: R1.1, R3.2
