CGCSAMR/Fotometro-Uchile/Arduino/DataloggerAtmosphere_Stable/DataloggerAtmosfera4_4_Lite_U_ino/DataloggerAtmosfera4_4_Lite_U_ino.ino

// SE ELIMINA CALCULO DE VARIANZA
// SE MIDE SOLO EL MAXIMO

// LED AMARILLO A0 (promedio1) ~570nm
// LED AZUL A1 (promedio2) ~400nm

// VERSION CON INTERFAZ

/*
  SD card datalogger
 
 This example shows how to log data from three analog sensors 
 to an SD card using the SD library.
 	
 The circuit:
 * analog sensors on analog ins 0, 1 (Aerosol's sensors), 4 and 5 (BMP 085 or BMP 180 sensor)
 * SD card attached to SPI bus as follows:
 ** MOSI - pin 11
 ** MISO - pin 12
 ** CLK - pin 13
 ** CS - pin 8
 ***LCD display connected to:
 ***RS - pin 9
 ***Enable -pin 10
 ***D4 - pin 6 
 ***D5 - pin 4 
 ***D5 - pin 3 
 ***D6 - pin 2 
 ****Buttons in pin 7, A2 and A3 (lite vertion only uses pin A2)
 *****Buzzer connected to pin 5
 
 created  24 Feb 2014
 by Somebody
 
 This example code is in the public domain.
 	 
 */
#include <LiquidCrystal.h>//The Arduino LiquidCrystal library
#include <SD.h>//SD library
#include <Time.h>//Time library  
#include <Wire.h>//I2C library  
#include <DS1307RTC.h>  // a basic DS1307 library that returns time as a time_t
#include <Adafruit_BMP085.h>
// initialize the LiquidCrystal library with the numbers of the interface pins
LiquidCrystal lcd(9, 10, 6, 4, 3, 2);
//Exposition time in millis
// On the olimex-MCI datalogger, CS is pin 8. Note that even if it's not
// used as the CS pin, the hardware CS pin (10 on most Arduino boards,
// 53 on the Mega) must be left as an output or the SD library
// functions will not work.
const int chipSelect = 8;//Constanst to use
const int buttonPin = A2;
const int buttonPin0 = 7;
const int buttonPin1 = A3;
#define TIEMPO_MEDICION 15000//Time of a medition in millis
//#define LARGO_MEDIDA 1//Number of measurements to take 
#define SEA_LEVEL_PRESSURE 101500//Sea level prssure
#define PIN_BUZZER 5//conetion to the pin buzzer

// One buffer by channel
//int buffer1[LARGO_MEDIDA];  // Saves the meditions of the aerosols's sensor
//int buffer2[LARGO_MEDIDA];  // #line = number of channels #columns = number of individual meditions
int buttonState = 0;
int buttonState0 = 0;// initial state of the A2 button
int buttonState1 = 0;
int inicio;// call int inicio
String data="";//call String data
File dataFile;

Adafruit_BMP085 bmp;//call to BMP 085 sensor

void setup()
{

  inicioBuzzer();//Initial sound
  lcd.begin(16, 2);//Initial LiquidCrystal Hardware
  lcd.setCursor(3,0);  
  lcd.print("Fotometro");//initial prin in LCD
  lcd.setCursor(2, 1);//resposion of a cursor
  lcd.print("FCFM Uchile");
  setSyncProvider(RTC.get);   // the function to get the time from the RTC
  if(timeStatus()!= timeSet) {//If the time can't work,it'll show the error in the LCD display
    lcd.clear();
    lcd.home();
    lcd.print("RTC Error");
  }
  pinMode(chipSelect, OUTPUT);//comunication with Olimex-MCI datalogger
  pinMode(buttonPin, INPUT);
  pinMode(buttonPin0, INPUT);//comunication with the A2 and 7 button   
  // see if the card is present and can be initialized, if it isn't,it'll show an error in the display :
  if (!SD.begin(chipSelect)) {
    lcd.clear();//SD validation
    lcd.home();
    lcd.print("SD card Error");
    errorSD();    
    // don't do anything more:, only sound the buzzer
    //return;
  }
  // indicate what have every column
  if(!SD.exists("DATALOG.CSV")){//Verifies if exists the file where the information is saves, if don't exists,il'll create a new file and write a head line
    File dataFile = SD.open("DATALOG.CSV", FILE_WRITE);
    dataFile.println("Year,Month,Day,Hour,Minute,Second,Sens_556_nm,Sens_414_nm,Temperature_C,Pressure_Pa,Altitude_m");
    dataFile.close();
  }
  if (!bmp.begin()) {//Check if the BMP 085 or 180 is presentnt, if it isn't, it'll show an error.
    lcd.clear();
    lcd.home();
    lcd.print("BMP Error");
    while (1) {
    }
  }
  lcd.clear();//Prin in the display the first menu
  lcd.home();
  lcd.print("Medir");
  lcd.setCursor(14, 0);
  lcd.print("<>");
  lcd.setCursor(14, 1);
  lcd.print("ok");

}

void loop()

{
  buttonState = digitalRead(buttonPin);
  buttonState0 = digitalRead(buttonPin0);//read the button input
  buttonState1 = digitalRead(buttonPin1);
  if (buttonState == HIGH){ 
    //if the buttton is pushed,the photometer will begin to measure
    // open the file. note that only one file can be open at a time,
    // so you have to close this one before opening another.
    // make a string for assembling the data to log:
    inicioBuzzer();//sound and changes the print in the display
    lcd.clear();
    lcd.home();
    lcd.print("Midiendo...");
    File dataFile = SD.open("DATALOG.CSV", FILE_WRITE);
    if (dataFile) {//write the date
      data += String(year()) + "," + String(month()) + "," + String(day()) + ",";
      data += String(hour()) + "," + String(minute()) + "," + String(second()) + ","; 
      dataFile.print(data);
      data = "";
      //reset of all the variables of a medition
      int sens1 = 0;
      int sensBuff1 = 0;
      int sens2 = 0;
      int sensBuff2 = 0;

      long inicio = millis();//time of the begin

      // Mide el maximo 
      while((millis() - inicio) < TIEMPO_MEDICION){
        
        sensBuff1 = analogRead(A0);
        sensBuff2 = analogRead(A1);
        
        sens1 = ( sens1 < sensBuff1 ) ? sensBuff1 : sens1 ;
        sens2 = ( sens2 < sensBuff2 ) ? sensBuff2 : sens2 ;

        
      }

      //writes the file with the information  
      data =  String(sens1) + "," + String(sens2) + ",";
      dataFile.print(data);  

      data = "";
      //read the temperature and pressure of the BMP 085 or BMP 180 sensor and writes these in the file
      data =  doubleToString(bmp.readTemperature()) + ","; 
      data += doubleToString(bmp.readPressure()) + ",";
      dataFile.print(data); 
      data = "";

      data = doubleToString(bmp.readAltitude(SEA_LEVEL_PRESSURE));
      dataFile.println(data);
      data = "";


      dataFile.close();

      finBuzzer();//final sound

      //imprimir max voltaje medido en pantalla
      lcd.clear();
      lcd.home();  
      lcd.print("Yellow");
      lcd.setCursor(8, 0);
      lcd.print("Blue");    
      lcd.setCursor(0, 1);
      lcd.print("  ");
      lcd.setCursor(0, 1);
      lcd.print(sens1);
      lcd.print("  ");
      lcd.setCursor(8, 1);
      lcd.print(sens2);

      while( !digitalRead(buttonPin) ){
      }

      delay(500);   

    }  


    // if the file isn't open, pop up an error:
    else {
      lcd.clear();
      lcd.home();
      lcd.println("TXT error");
    }
    //reset the initial metition information
    lcd.clear();
    lcd.home();
    lcd.print("Medir");
    lcd.setCursor(14, 0);
    lcd.print("<>");
    lcd.setCursor(14, 1);
    lcd.print("ok");

  }
  else if (buttonState0 == HIGH){
    lcd.clear();
    lcd.home();
    lcd.println("Conenctado");
    Serial.begin(9600);
    while (!Serial.available()) {
      // wait for serial port to connect. Needed for Leonardo only
    }
    // open the file. note that only one file can be open at a time,
    // so you have to close this one before opening another.
    dataFile = SD.open("DATALOG.CSV", FILE_READ);

    // if the file opened okay, write to it:
    if (dataFile) {
      while (dataFile.available()) {
        Serial.write(dataFile.read());
      }
      Serial.write(64);
      dataFile.close();
      lcd.clear();
      lcd.home();
      lcd.print("Medir");
      lcd.setCursor(14, 0);
      lcd.print("<>");
      lcd.setCursor(14, 1);
      lcd.print("ok");
    } 
    else {
      // if the file didn't open, print an error:
      Serial.println("error opening DATALOG.CSV");
    }

  }
  else if (buttonState1 == HIGH){
    lcd.clear();
    lcd.home();
  // Print a message to the LCD.
    lcd.print("Yellow");
    lcd.setCursor(8, 0);
    lcd.print("Blue");
    
    int amarillo;
    int azul;
    int maxAmarillo = 0;
    int maxAzul = 0;
    buttonState1 = 0;
    delay(500);
    
    while( !digitalRead(buttonPin1) ){

      // Mide el maximo 
      
      for(int i = 0; i < 300; i++)
      {
        
      amarillo = analogRead(A0);
      azul = analogRead(A1);
        
      maxAmarillo = ( maxAmarillo < amarillo ) ? amarillo : maxAmarillo ;
      maxAzul = ( maxAzul < azul ) ? azul : maxAzul ;
        
      }
       
      lcd.setCursor(0, 1);
      lcd.print(maxAmarillo);
      lcd.setCursor(8, 1);
      lcd.print(maxAzul);
      
    }
  
  delay(500);
    lcd.clear();
    lcd.home();
    lcd.print("Medir");
    lcd.setCursor(14, 0);
    lcd.print("<>");
    lcd.setCursor(14, 1);
    lcd.print("ok");
  }
}


String doubleToString(double num){
  //it takes a double number and return it like a string

  char buf[32]; 
  String palabra;

  dtostrf(num,4,8,buf);
  // dtostrf( [doubleVar] , [sizeBeforePoint] , [sizeAfterPoint] , [WhereToStoreIt] )
  palabra = String(buf);  // cast it to string from char 
  return palabra;
}


void inicioBuzzer(){
  //configuration for the initial sound
  tone(PIN_BUZZER, 1046, 220); //tone(pin, frecuencia, duracion (milisegundos))

}


void finBuzzer(){
  //configuration to the final sound
  tone(PIN_BUZZER, 1046);
  delay(220);
  noTone(PIN_BUZZER);
  tone(PIN_BUZZER, 1046, 220);
  delay(220);

}


void errorSD(){
  //sound of the SD error
  while(true){

    tone(PIN_BUZZER, 698);
    delay(300);
    noTone(PIN_BUZZER);

    delay(550);

  }
}
