CGCSAMR/Fotometro-Uchile/(commit log)

2014-01-07 Planos estructurales
    algunas versiones (sin ordenar)
    [Ensamblaje1.SLDASM, central lateral tercer piso.SLDPRT, central primer piso.SLDPRT, central segundo piso.SLDPRT, central tercer piso.SLDPRT, central trasero tercer piso.SLDPRT, cuarto piso PRINT edition.SLDPRT, cuarto piso.SLDPRT]
2014-01-07 más cambios
    [circulo de la muerte.SLDPRT]
2014-01-08 Alguno cambios, próximamente, muchos más
    :):)
    [segundo piso.SLDPRT]
2014-01-09 Placas electronicas
    [.kicad_pcb-B_Cu.gbl, .kicad_pcb-B_SilkS.gbo, .kicad_pcb-Edge_Cuts.gbr, .kicad_pcb-F_Cu.gtl, .kicad_pcb-F_SilkS.gto, .kicad_pcb.drl]
2014-01-09 Más modificaciones a los planos
    yei
    [circulo de la muerte.SLDPRT, cuarto piso PRINT edition.SLDPRT, cuarto piso.SLDPRT, quinto piso.SLDPRT, segundo piso.SLDPRT, tercer piso.SLDPRT]
2014-01-09 Ultima de la noche
    Falta tabiques del anclaje y determinar ubicación de pantalla
    [segundo piso.SLDPRT]
2014-01-09 Agregado espacio para pantalla LCD
    recordar que es el mínimo posible, luego todo el circuito seráfuera de
    la carcasa
    [segundo piso.SLDPRT, tercer piso.SLDPRT]
2014-01-09 Plano terminados
    [central cuarto piso.SLDPRT, central lateral tercer piso.SLDPRT, central trasero tercer piso.SLDPRT, cuarto piso PRINT edition.SLDPRT, cuarto piso.SLDPRT, quinto piso PRINT.SLDPRT, quinto piso.SLDPRT, soporte lateral.SLDPRT]
2014-01-09 Planos Corregidos y STL para imprimir
    [Ensamblaje V1.3.SLDASM, central cuarto piso.STL, central lateral tercer piso.STL, central segundo piso.STL, central tercer piso.SLDPRT, central tercer piso.STL, central trasero tercer piso.STL, circulo de la muerte.STL]
2014-01-14 Codigo Arduino con librerias correspondientes
2014-01-14 Mira provisoria
    [Ensamblaje1 - mira-1.STL, Ensamblaje1 - mira2-1.STL, Ensamblaje1 - mira2-2.STL, Ensamblaje1 - mira3-1.STL, anillo.SLDPRT, mira tipo A.SLDPRT, mira.SLDASM, mira.SLDPRT]
2014-01-14 más piezas
    [segundo piso.SLDPRT, soporte.SLDPRT]
2014-01-16 modificación pequeña
    [anillo.SLDPRT]
2014-01-16 piezas para la versión final
    [adaptador.SLDPRT, anillo soporte.SLDPRT, soporte.SLDPRT]
2014-01-16 ediciones de prueba
    [adaptador.STL, anillo soporte.STL, quinto piso PRINT.STL, segundo piso.STL, soporte lateral.STL]
2014-01-16 no se
    [anillo.STL, mira tipo A.STL]
2014-01-17 modificaciones para versión release
    [cuarto piso PRINT edition.SLDPRT, quinto piso PRINT.SLDPRT, segundo piso.SLDPRT, soporte.SLDPRT]
2014-01-17 un detalle
    [quinto piso PRINT.SLDPRT]
2014-01-18 planos casi definitivos
    [Ensamblaje V1.3.SLDASM, adaptador tipo A.SLDPRT, adaptador tipo B.SLDPRT, cuarto piso PRINT edition.SLDPRT, quinto piso PRINT.SLDPRT, segundo piso.SLDPRT, soporte.SLDPRT]
2014-01-20 más detalles
    agujeros para nueva placa para interfaz.
    [soporte.SLDPRT]
2014-01-23 Ultimo ensamblaje
    [Ensamblaje V1.3.SLDASM, adaptador tipo A.SLDPRT, adaptador tipo A.STL, adaptador tipo B.SLDPRT, central segundo piso.SLDPRT, central segundo piso.STL, central tercer piso.SLDPRT, central tercer piso.STL]
2014-01-26 cambios varios
    [digibyte.SLDPRT, quinto piso molde.SLDDRW, quinto piso molde.SLDPRT, segundo piso.SLDPRT, soporte.SLDPRT]
2014-02-21 modificaciones convergentes
    [adaptador tipo A prueba.SLDPRT, adaptador tipo A.SLDPRT, adaptador tipo A.STL, central segundo piso.SLDPRT, central segundo piso.STL, central segundo pisoMAKERBOT.SLDPRT, central tercer pisoMAKERBOT.SLDPRT, corte 1.SLDDRW]
2014-07-22 Apagando el fuego con bencina
    Rescate de la borrada rama Kfop (QEPD) :(
    [Ensamblaje1.SLDASM, Ensamblaje12.SLDASM, INTER2.kicad_pcb, Inventario pernos.xlsx, adaptador tipo A prueba 2013.SLDPRT, adaptador tipo A prueba 2013.STL, adaptador tipo A prueba.SLDPRT, adaptador tipo A prueba.STL]
2014-07-22 Sigue el cuento
2014-07-22 Arreglo versión pseudo-estable
    Orden et orbi
    [Ensamblaje V1.3.SLDASM, Ensamblaje1 - mira-1.STL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]
2014-07-23 Corregido archivo "DateStrings.cpp" de libreria Time
2014-07-25 Modificaciones Faltantes
    Falta el molde
    [adaptador 2G.STL, adaptador tipo A prueba 2013.SLDPRT, segundo piso MAKERBOT.SLDPRT, soporte lateral MAKERBOT 2.SLDPRT, soporte lateral MAKERBOT 2.STL, soporte lateral MAKERBOT.SLDPRT, soporte lateral MAKERBOT.STL, soporte prueba mejorado.SLDPRT]
2014-08-01 Reubicación piezas inútiles siguiente fase
    [adaptador tipo A prueba 2013.STL, adaptador tipo A prueba.STL, adaptador tipo A.STL, central segundo piso.STL, quinto piso PRINT.STL, soporte lateral prueba.STL, soporte lateral.STL]
2014-08-02 Arreglo dado éxito
    [Molde rehecho.SLDPRT, adaptador tipo A 2G.SLDPRT, adaptador tipo A 2G.STL, adaptador tipo A prueba 2013.SLDPRT]
2014-08-05 ultimas mejoras
    [soporte prueba mejorado.SLDPRT]
2014-08-20 Nuevo formato de orden, espero sea más comodo
    [Ensamblaje1.SLDASM, Ensamblaje12.SLDASM, INTER2.kicad_pcb, Molde rehecho.SLDPRT, adaptador 2G.STL, adaptador tipo A 2G.SLDPRT, adaptador tipo A 2G.STL, adaptador tipo A prueba 2013.SLDPRT]
2014-08-22 fixed names
    [Ensamblaje1.SLDASM, Ensamblaje12.SLDASM, Molde rehecho.SLDPRT, adaptador 2G.STL, adaptador tipo A 2G.SLDPRT, adaptador tipo A 2G.STL, adaptador tipo A prueba 2013.SLDPRT, adaptador tipo A prueba 2013.STL]
2014-08-22 We come back!
    [Ensamblaje1.SLDASM, Ensamblaje12.SLDASM, Molde rehecho.SLDPRT, adaptador 2G.STL, adaptador tipo A 2G.SLDPRT, adaptador tipo A 2G.STL, adaptador tipo A prueba 2013.SLDPRT, adaptador tipo A prueba 2013.STL]
2014-08-22 ahora si
    [Ensamblaje1.SLDASM, Ensamblaje12.SLDASM, Molde rehecho.SLDPRT, adaptador 2G.STL, adaptador tipo A 2G.SLDPRT, adaptador tipo A 2G.STL, adaptador tipo A prueba 2013.SLDPRT, adaptador tipo A prueba 2013.STL]
2014-08-23 Agregadas placas completas
    Sin arreglar
    [.kicad_pcb.kicad_pcb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]
2014-10-16 added pysolar
    [pysolar_v_usno.csv]
2014-10-30 Se anota valores de resistencias para pre-calibracion
2015-01-06 fixed DataloggerAtmosfera4_2_Lite to be read by MATLAB, now stable ver is DataloggerAtmosfera4_3_Lite
    [DATALOG.CSV]
2015-01-06 Added MATLAB-like script
    [DATALOG.CSV]
2015-01-09 Se abre carpeta de C
2015-01-12 CIMEL tiene todos los scripts Math para interpretar medición
2015-01-14 Contabilidad
    Subí la contabilidad actual.
    [Contabilidad nueva.xlsx]
2015-01-14 Actualizada última boleta 14-enero
    [Contabilidad nueva.xlsx]
2015-01-15 Boletas agregadas
    [Contabilidad nueva.xlsx]
2015-01-15 Agregar pantalla a programa de medicion
2015-01-16 Agregadas las entregas
    [Contabilidad nueva.xlsx]
2015-01-16 Se elimina calculo de varianza, se mide solo maximo. Un-tested
2015-01-16 Observaciones para futura documentación
2015-01-16 Math y Arduino actualizados
    [DATALOG.csv, DATALOG_FALVEY.csv, DATALOG_MARCOS.csv, DATALOG_ROBERTO.csv]
2015-01-19 Nueva version de programa tratamiento de datos
2015-01-19 Se agrego funcion sun_position modificada
    [DATALOG_MARCOS.csv]
2015-01-19 programa de AOT listo, falta corregir long. de onda
2015-01-19 Arreglado formato de archivo de salida
    [DataloggerAtmosfera4_4_Lite.ino]
2015-01-20 Extraccion de datos y calculo de AOT Fotometro Calan estable
    [DATALOG.csv, DATALOG_FALVEY.csv, DATALOG_MARCOS.CSV, DATALOG_MARCOS.csv, DATALOG_ROBERTO.csv]
2015-01-20 Se agregan longitudes de onda eq correctas
    [DataloggerAtmosfera4_4_Lite.ino]
2015-01-20 nuevo formato de datos
    [DATALOG_FALVEY.CSV, DATALOG_MARCOS.CSV]
2015-01-20 version 20 enero
    [DATALOG_FALVEY.CSV, DATALOG_MARCOS.CSV, DATALOG_ROBERTO.CSV]
2015-01-20 Versiones U
    [data_marcos.csv]
2015-01-21 Problemas es la respuesta
    versión inestable y reembolsos
    [Reembolso sin Egreso.xls]
2015-01-22 version 22 enero 2015
    [DATALOG_FALVEY.CSV, DATALOG_MARCOS.CSV, DATALOG_ROBERTO.CSV, datos_falvey.CSV, datos_marcos.CSV, datos_roberto.CSV]
2015-01-23 Datos para graficos
    [datos_falvey_fix.CSV, datos_marcos_fix.CSV, datos_marcos_fix.csv, datos_roberto_fix.CSV]
2015-01-28 mediciones san cristobal
    [datos_falvey.CSV, datos_falvey.csv, datos_marcos.CSV, datos_marcos.csv, datos_roberto.CSV, datos_roberto.csv]
2015-01-29 contabilidad actualizada
    [Contabilidad nueva.xlsx, DATALOG_FALVEY.CSV, datos_falvey.CSV, datos_falvey_fix.csv, datos_marcos.CSV, datos_marcos_fix.CSV, datos_roberto.CSV, datos_roberto_fix.CSV]
2015-01-29 Arreglado OnDemandMax, viva el comandante Chavez!
    [DataloggerAtmosfera4_4_Lite_U_ino.ino]
2015-01-30 Programa realizado de optimización
2015-02-02 52 actualizaciones!!
    [molde corte 2.SLDDRW, quinto piso PRINT corte.SLDDRW]
2015-02-10 Función filtro
    7 sensor azul, 8 sensor rojo
2015-02-10 más fix
    [data_MARCOS_fix.csv, data_ROBERTO_fix.csv]
2015-02-10 datos la parva
    [data_FALVEY.csv, data_MARCOS.csv, data_ROBERTO.csv]
2015-02-10 data falvey fix
    [data_FALVEY_fix.csv]
2015-02-10 procesamiento langley plot
    [data_FALVEY_fix.CSV, data_MARCOS_fix.CSV, data_ROBERTO_fix.CSV, datos_falvey.CSV, datos_falvey_fix.CSV, datos_marcos.CSV, datos_marcos_fix.CSV, datos_roberto.CSV]
2015-02-11 Documentos calibracion
    [tabla_calibracion_laParva.ods]
2015-03-11 Datos previos campana calibracion
    [data_falvey.csv, data_marcos.csv, data_roberto.csv]
2015-03-12 Documentos filtrados
    revisar archivos data_'fotometro'_30.csv
    [data_falvey_30.csv, data_marcos_30.csv, data_roberto_30.csv]
2015-03-13 Calibracion de febrero incorporada
    [data_falvey_30.CSV, data_marcos_30.CSV, data_roberto_30.CSV]
2015-05-16 Codigo para el experimento de calibracion por temperatura
2015-07-09 Se agrega calibracion
    [DATALOG_FALVEY.CSV, DATALOG_MARCOS.CSV, DATALOG_ROBERTO.CSV, data_FALVEY_fix.CSV, data_MARCOS_fix.CSV, data_ROBERTO_fix.CSV, data_falvey_30.CSV, data_marcos.csv]
2015-07-11 Correccion calibracion
    [falvey_cor.CSV]
